skellent/GreenHouse/prompts/unpacked_original/word/media/image8.jpg

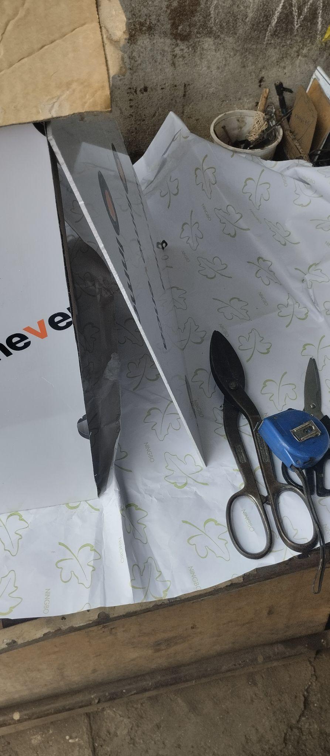
prompts/unpacked_original/word/media/image8.jpg
