skellent/GreenHouse/prompts/unpacked_original/word/media/image4.jpg

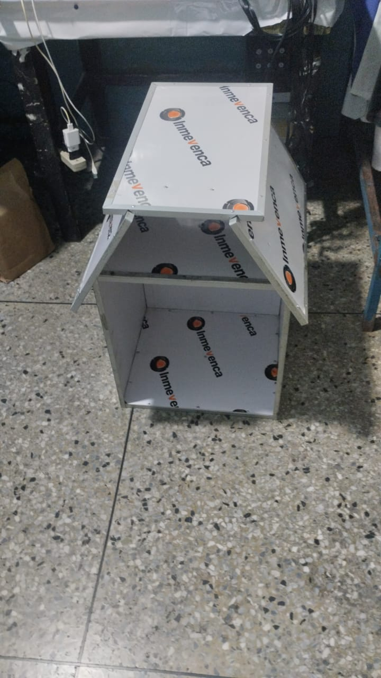
prompts/unpacked_original/word/media/image4.jpg
