skellent/GreenHouse/prompts/INFORME_ORIGINAL.docx

Olimpiadas de Robótica Creativa (ORC)

COMPETENCIA INGENIO CREATIVO

INFORME TÉCNICO

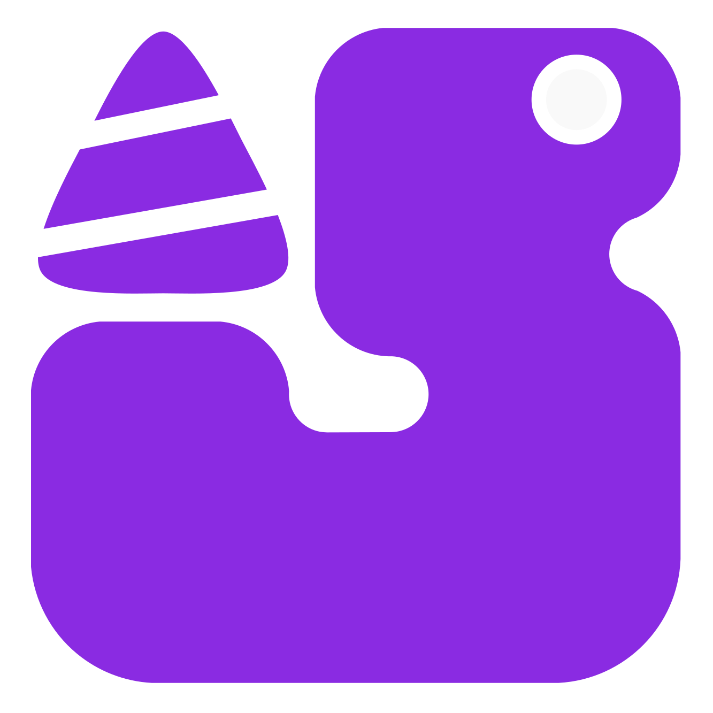
[picture p3: figure]

Skellent

Skell’s GreenHouse

Integrantes:------------------------------------------------

- Robert Rodríguez, V-32.942.787, 17 Años.----
- Christopher Ramírez, V-33.499.939, 16 Años.
- Fabiana Hernández, V-34.648.529, 14 Años.-

Tutor: Jesús Pérez, V-30.759.313

Barquisimeto, Mayo 2026

ÍNDICE

RESÚMEN DE LA IDEA DE PROYECTO 2

INTEGRANTES DEL EQUIPO DE PROYECTO 2

IMPLEMENTACIÓN DEL PROYECTO 3

INICIO 3

DESARROLLO 4

PRINCIPALES DIFICULTADES Y SOLUCIONES 4

MATERIALES DEFINITIVOS 4

PROGRAMACIÓN 5

ASPECTOS MECÁNICOS Y FUNCIONAMIENTO 5

ALGORITMO DE CONTROL 5

ESTRUCTURA DEL CÓDIGO 6

EJECUCIÓN 6

EVALUACIÓN DEL DESEMPEÑO 6

FORTALEZAS DEL SISTEMA 7

OPORTUNIDADES DE MEJORA 7

EVALUACIÓN Y ANÁLISIS DEL PROYECTO 7

LOGROS OBTENIDOS 7

APRENDIZAJES 8

ESCENARIOS DE ESCALADO 8

ESQUEMA ELECTRÓNICO 8

ESQUEMA DE FLUJO ELÉCTRICO 8

REFERENCIAS BIBLIOGRÁFICAS 8

FOTOGRAFÍAS 8

# RESÚMEN DE LA IDEA DE PROYECTO

Skell’s GreenHouse es un sistema de invernadero autónomo, portátil y modular, diseñado para facilitar el cultivo de hortalizas de pequeño porte como cebollín y zanahoria o plantas que requieran de un cuidado preciso, como flores. Su propósito es resolver la dificultad que enfrentan muchas personas al intentar mantener plantas durante su germinación y crecimiento, especialmente en espacios domésticos y educativos.

El prototipo integra un microcontrolador ESP32, sensores de humedad de tierra, temperatura ambiente, nivel de agua, y una bomba de riego, contando también con un servomotor para el posicionamiento adecuado del sensor de humedad de tierra. Además, cuenta con luces UV para suplementar la fotosíntesis y una aplicación que muestra en tiempo real las condiciones del cultivo. Una de sus características innovadoras es la integración de una IA en la ESP32, entrenada para identificar del tipo de cultivo así como el cuidado y mantenimiento del mismo, permitiendo el monitoreo remoto desde cualquier dispositivo conectado a la misma red. (Una de las actualizaciones realizadas al prototipo para la Fase Regional, fue la eliminación de la Pantalla TFT 2´8, el reemplazo de la página web por la aplicación móvil y la integración de la IA)

El proyecto se enmarca en el Motor Agroalimentario del estado Lara, contribuyendo a la producción de alimentos a pequeña escala y fomentando la educación agrícola en escuelas y hogares. Su diseño modular permite intercambiar macetas fácilmente, adaptándose a distintas especies.

Las pruebas realizadas en el hogar de uno los integrantes demostraron un crecimiento saludable y continuo del cebollín, con un sistema de riego preciso y notificaciones claras en la aplicación. De esta forma, Skell’s GreenHouse no solo automatiza el cuidado de las plantas, sino que también democratiza el acceso a la tecnología agrícola, promoviendo la soberanía alimentaria desde el ámbito local.

# INTEGRANTES DEL EQUIPO DE PROYECTO

El equipo Skellent se formó a partir de la amistad y el interés compartido por la robótica y la electrónica. Los integrantes Robert y Christopher se conocían por proyectos previos elaborados en conjunto, y al momento de considerar elaborar el proyecto, decidieron incorporar a Fabiana; Robert y Fabiana se conocen por estudiar en el mismo colegio, mientras que Christopher estudia en otro, pero eso no fue una limitante y en conjunto decidimos unir nuestras habilidades para abordar un problema real observado en sus hogares: el olvido del riego y la falta de control ambiental para plantas pequeñas. Cada miembro asumió roles específicos basados en sus fortalezas:

- Robert Rodríguez (17 años): Responsable de la programación del ESP32, creación de la aplicación y entrenamiento de la IA
- Christopher Ramírez (16 años): Diseño mecánico, electrónico y estructural. Encargado del diseño de la carcasa, el sistema modular de macetas y la impresión 3D de los componentes.
- Fabiana Hernández (14 años): Electrónica y documentación. Supervisó el conexionado de sensores, actuadores y la fuente de alimentación, además de gestionar las pruebas y el registro fotográfico.

# IMPLEMENTACIÓN DEL PROYECTO

## INICIO

La idea de Skell’s GreenHouse nació de experiencias previas con un proyecto anterior a menor escala: un medidor de datos de una maceta. Al observar que muchas plantas en sus hogares morían por falta de atención durante viajes o por condiciones ambientales desfavorables, los integrantes decidieron ampliar el concepto para crear un sistema autónomo que no solo monitoreara, sino que también actuara para mantener las plantas saludables.

Antes de iniciar, investigaron productos comerciales como sistemas de riego automático e invernaderos domésticos. Encontraron que la mayoría eran costosos, no permitían la portabilidad y no ofrecían opciones de monitoreo remoto. También revisaron trabajos académicos sobre agricultura de precisión a pequeña escala, que inspiraban el uso de sensores asequibles y microcontroladores como el ESP32.

Al inicio del proyecto, los materiales disponibles eran limitados: una placa ESP32, algunos sensores, una bomba de agua y cartón para estructurar el primer boceto.

## DESARROLLO

El desarrollo se organizó en fases:

1. Definición de requerimientos.
2. Diseño conceptual.
3. Prototipado electrónico.
4. Construcción mecánica.
5. Programación y pruebas.
6. Iteración final.
7. Mejoras

Aunque es el primer prototipo funcional, se realizaron dos iteraciones internas: una versión con estructura de cartón para validar la estructura y sus medidas, y la versión final con PVC expandido y marcos de aluminio.

### PRINCIPALES DIFICULTADES Y SOLUCIONES

- Configuración de la IA: Se utilizo la librería del Tensor Flow Lite ESP32 para la creación de la IA , para lo cual fue necesario realizar múltiples pruebas para se logró estabilización y correcta interacción.
- Suministro de Agua: Inicialmente la bomba no alcanzaba a succionar el agua desde el tanque. Se aumentó la altura de la manguera y se colocó la bomba en la parte baja del tanque.
- Modularidad: Cada pieza del invernadero (tanto estructurales como electrónicas) están hechas para ser de fácil acceso y fácil recambio en caso de ser necesario. Así como con la ayuda de un motor paso a paso se realiza la inserción del sensor de humedad de tierra, permitiendo un fácil intercambio de macetas

### MATERIALES DEFINITIVOS

- Estructura: láminas de PVC expandido, marcos de aluminio, piezas impresas en 3D (PLA-PETG).
- Electrónica: ESP32, sensor de humedad de suelo (Fc-28), sensor de temperatura y humedad DHT22, sensor de nivel de agua (genérico), bomba de agua DC 5V, motor paso a paso 28byj-48, sensores de temperatura DS18B20, fuente conmutada 5V 5A, resistencias, transistores, luces UV, Botón, Baquelita, modulo reductor de voltaje step down LM2596 y fotoresistencia (Para esta fase fue añadida la fotoresistencia , las luces Led, Sensores de temperatura DS18B20)
- Conexiones: cables DuPont, conectores terminales para partes de alto consumo.

### PROGRAMACIÓN

Se utilizó Arduino C++ en el Arduino IDE debido a la gran cantidad de librerías disponibles (WiFi, Tensor Flow Lite ESP32, DHT, etc.) que aceleraron el desarrollo.

Para desarrollar la aplicación de monitoreo se utilizó el lenguaje Java Script ya que permite una amplia optimización y mejor estética.

(La aplicación se agrego para la Fase Regional)

### ASPECTOS MECÁNICOS Y FUNCIONAMIENTO

El sistema se divide electrónicamente en:

1. Placa principal: Es la que tiene el esp32 y se encarga del manejo de sensores y actuadores
2. Placas Secundarias: módulos como el Fc-28, las luces UV, etc requieren de placas adicionales para su correcto funcionamiento, las cuales están conectadas a la principal de tal manera que permitan una fácil manipulación y reemplazo en caso de ser necesario.

Mecánica-estructuralmente se divide en:

3. Marco de aluminio: Es la estructura base que le da fuerza y estabilidad
4. Placas de PVC expandido: Estas aíslan a los componentes y la planta del exterior, protegiéndolos del agua, luz, calor, etc.
5. Puerta para la observación de la planta, con sistema de imanes

## ALGORITMO DE CONTROL

1. El ESP32 ejecuta un bucle principal (Core 1) que:
  - Se encarga de la gestión de la inteligencia artificial y el flujo lógico de los actuadores.
  - Coordina la lectura de periféricos y el formateo de datos para la red neuronal.
  - Proporciona retroalimentación visual del estado del sistema mediante un LED Neopixel (Blanco: Inicio, Verde: Éxito IA, Rojo: Error IA).
2. Se ejecuta el proceso de actualización de sensores:
  - Se leen los datos físicos (DHT, Ultrasonido, Humedad de suelo, Nivel de agua, Fotoresistencia).
  - Se actualizan las variables globales con los valores del entorno en tiempo real.
3. La Red Neuronal (IA) procesa los datos:
  - Formateo: Los datos crudos se normalizan (escala de 0.0 a 1.0) para ser digeribles por el modelo.
  - Inferencia: El intérprete de TensorFlow Lite analiza los datos de entrada.
  - Control de Actuadores: Se actualizan las variables de salida (uv, bomba) según la decisión de la IA.
4. El Servidor Web es delegado al procesador secundario (Core 0):
  - Gestiona la conexión WiFi de forma independiente para no interrumpir el ciclo de la IA.
  - Expone una API JSON con los datos de los sensores y sirve capturas en tiempo real de la cámara OV2640.

## ESTRUCTURA DEL CÓDIGO

- Setup():
  - Inicializa la comunicación Serial y los sensores (DHT, OneWire, Ultrasonido).
  - Configura los canales PWM (LEDC) para los actuadores (Bombas y luces UV).
  - Inicia la cámara OV2640 gestionando la memoria DRAM.
  - Carga el modelo de IA en la tensor_arena y prepara los tensores de entrada/salida.
  - Crea la tarea del Servidor Web asignándola específicamente al núcleo 0 con xTaskCreatePinnedToCore.
- Loop():
  - Indica el inicio de la iteración con el Neopixel.
  - Llama a actualizarSensores() para refrescar las variables globales.
  - Ejecuta formatearSensores() para normalizar los valores.
  - Inserta los datos en el modelo de IA y ejecuta el interpreter->Invoke().
  - En base al éxito o error de la IA, actualiza el estado de los actuadores y el color del LED.
  - Genera un reporte de monitoreo mediante la función log().
- Funciones Secundarias:
  - actualizarSensores(): Lee pines analógicos y digitales, aplicando map y constrain para calibrar niveles de agua y tierra.
  - formatearSensores(): Realiza las operaciones matemáticas para convertir los rangos de sensores a valores flotantes compatibles con la red neuronal.
  - ServidorWeb(): Bucle infinito en el núcleo 0 que maneja peticiones HTTP, genera el JSON de estado y sirve el buffer de imagen de la cámara.
- Variables Globales:
  - Sensores: sen_humedadAire, sen_humedadTierra, sen_litrosAgua, sen_alturaPlanta, sen_temperatura, sen_luz.
  - IA (Raw): raw_temperatura, raw_humedadAire, raw_humedadTierra, raw_luz, raw_litrosAgua.
  - Actuadores: uv, bomba, camaraOk.

## EJECUCIÓN

El prototipo se sometió a prueba en la casa de uno de los integrantes (Robert). En el que se instaló la maceta con un cebollín en crecimiento para ver cómo se desarrollaba dentro del prototipo, mostrando buenos resultados.

### EVALUACIÓN DEL DESEMPEÑO

El sistema se consideró óptimo cuando se cumplieron tres criterios:

1. Crecimiento Continuo: la planta demostró un crecimiento continuo y saludable.
2. Precisión en El Riego y Luz: Las IA demostró ser efectiva, debido a que la bomba se activó solo cuando la humedad del suelo descendió por debajo del umbral configurado, sin inundaciones ni sequías y las luces se activaron el tiempo indicado con la potencia indicada.
3. Confiabilidad de la aplicación: los datos mostrados coincidían con las mediciones manuales realizadas con instrumentos de referencia.

### FORTALEZAS DEL SISTEMA

- Autonomía Total mediante la IA: no requiere intervención humana para mantener las condiciones adecuadas (solo para el rellenado ocasional del tanque de agua, aunque se tiene pensado una solución al respecto).
- Modularidad: permite cambiar de cultivo fácilmente, y esta diseñado electrónica y estructuralmente para ser fácilmente reparable o modificable.
- Monitoreo Remoto: la aplicación facilita el monitoreo remoto de la planta desde cualquier dispositivo conectado a la misma red.
- Portabilidad: su tamaño y peso permiten trasladarlo sin dificultad (a comparación de otros invernaderos).

### OPORTUNIDADES DE MEJORA

- Incorporar sensores de pH y nutrientes para la app.
- Optimizar el consumo energético mediante modos de suspensión.
- Desarrollar una base de datos de plantas con parámetros predefinidos para facilitar la configuración.
- Añadir un sistema de recolección de agua mediante placas peltier

# EVALUACIÓN Y ANÁLISIS DEL PROYECTO

Skell’s GreenHouse responde a la problemática de la seguridad alimentaria desde el nivel doméstico y educativo, en línea con el Motor Agroalimentario del estado Lara. Al automatizar el cuidado de hortalizas pequeñas y plantas delicadas o de difícil cuidado, reduce la dependencia de la atención humana constante y permite a familias y escuelas producir sus propios alimentos o cuidar plantas exóticas de manera sencilla y controlada. Además, fomenta el interés por la agricultura y la tecnología, especialmente en jóvenes, al ofrecer una plataforma didáctica.

## LOGROS OBTENIDOS

- Se consolidó un equipo interdisciplinario con roles claros y comunicación efectiva.
- Se logró un prototipo completamente funcional y autónomo.
- Se documentó el proceso completo, dejando evidencia del trabajo original y las soluciones implementadas.

## APRENDIZAJES

- La importancia de la modularidad para facilitar pruebas y mantenimiento.
- El manejo avanzado de librerías para la implementación de IA y servidores web en ESP32.
- La necesidad de considerar el entorno físico (humedad, temperatura) en el diseño mecánico para evitar daños a la electrónica.

## ESCENARIOS DE ESCALADO

- Escala educativa: Versión en kit de componentes para escuelas, con manuales didácticos.
- Escala comunal: Adaptación a un módulo más grande que permita el cultivo de múltiples macetas en espacios comunitarios.
- Escala comercial: Reducción de costos mediante diseño optimizado para producción en serie, manteniendo la modularidad.

# ESQUEMA ELECTRÓNICO

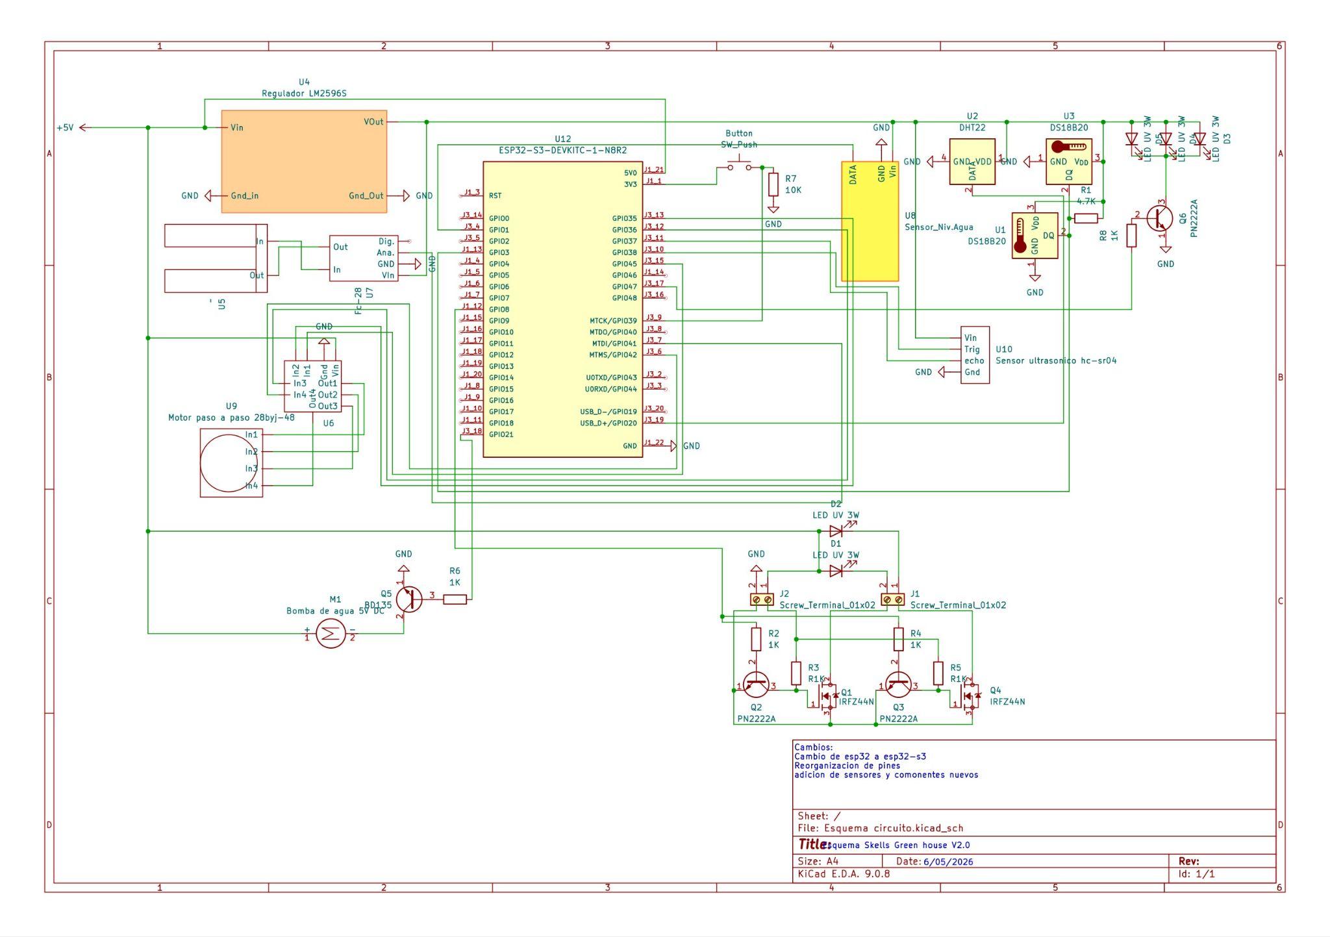
[picture p4: figure]

# ESQUEMA DE FLUJO ELÉCTRICO

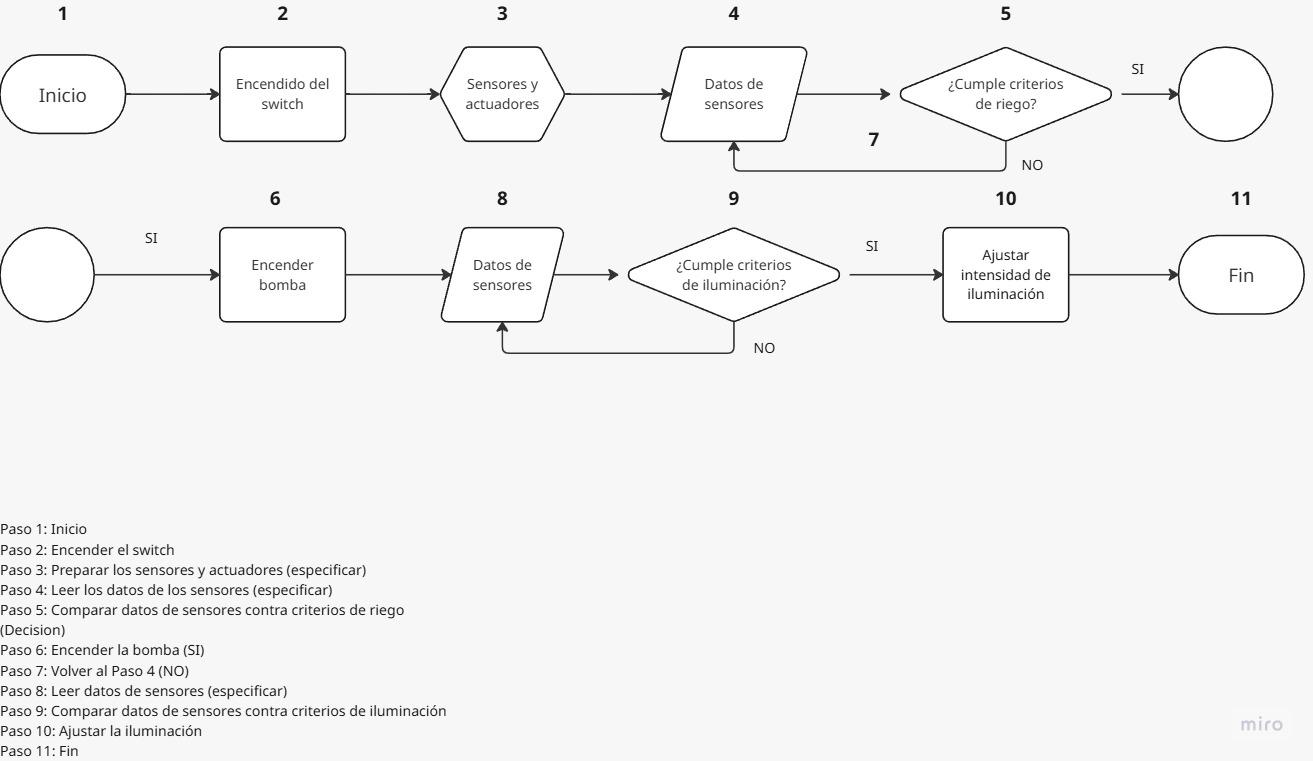
[picture p5: figure]

# FOTOGRAFÍAS

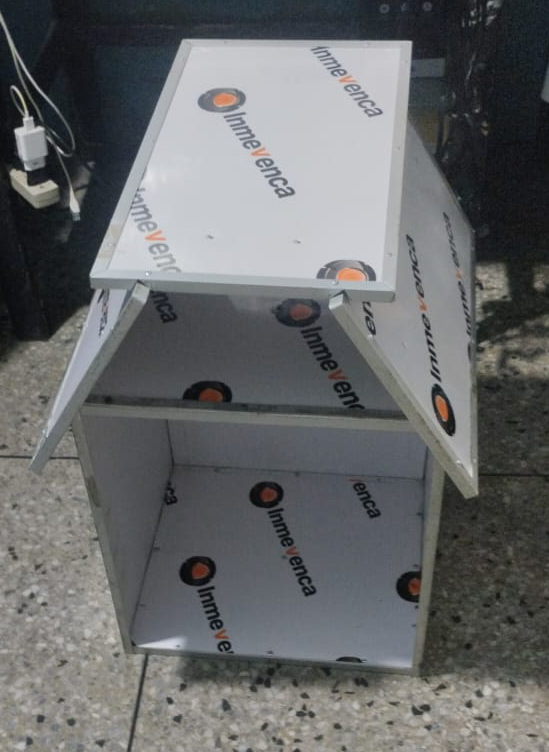
[picture p6: figure]
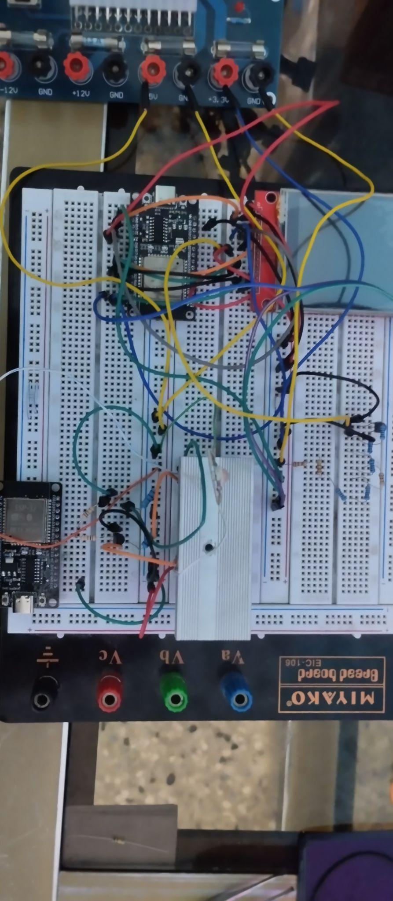
[picture p7: figure]
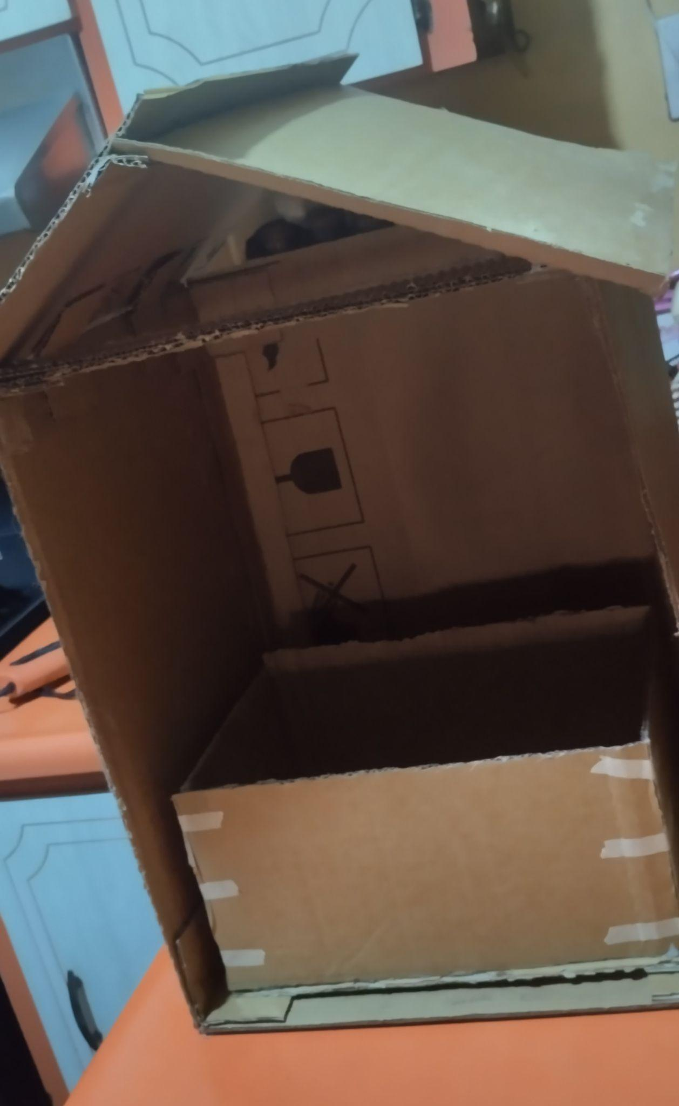
[picture p8: figure]
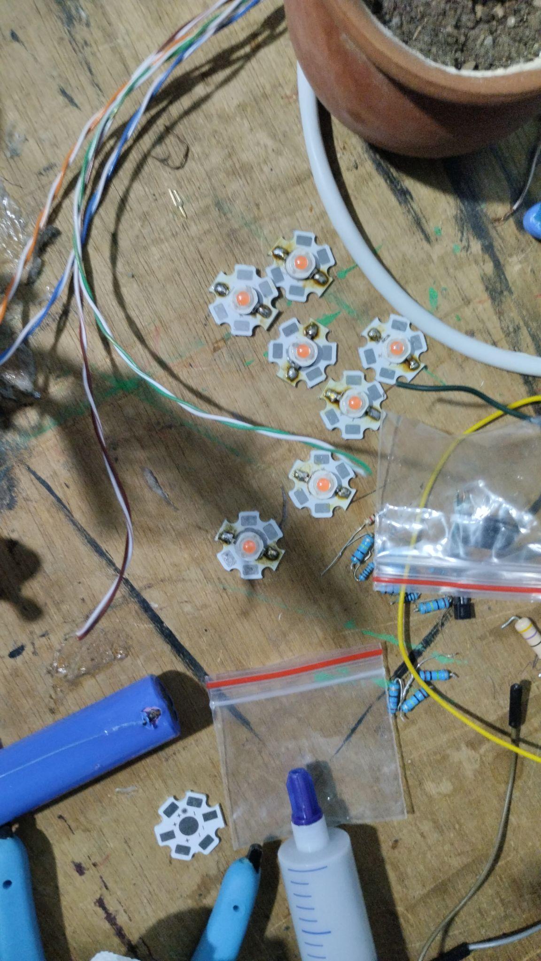
[picture p9: figure]
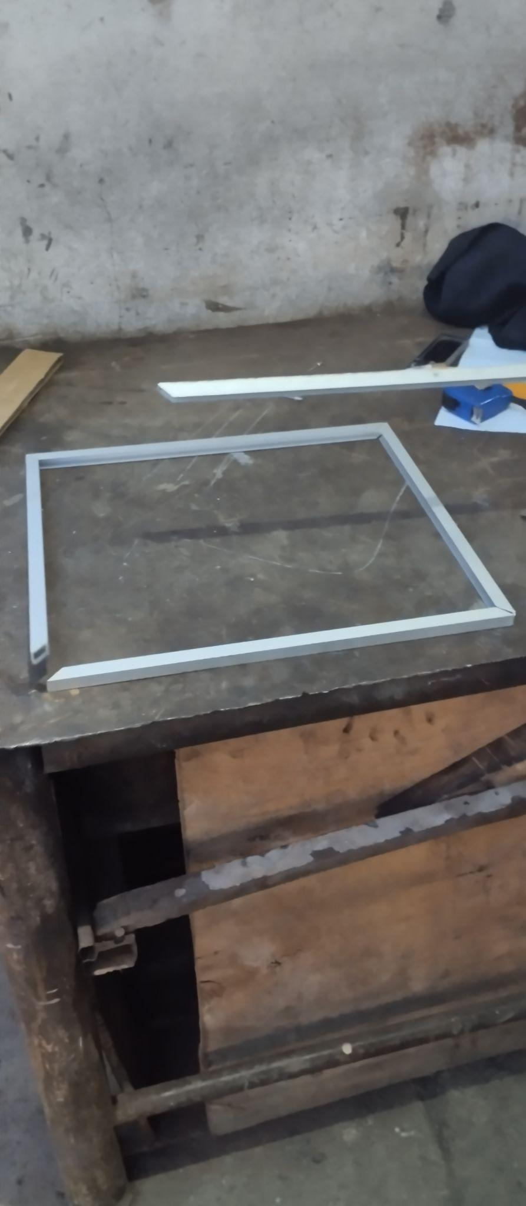
[picture p10: figure]
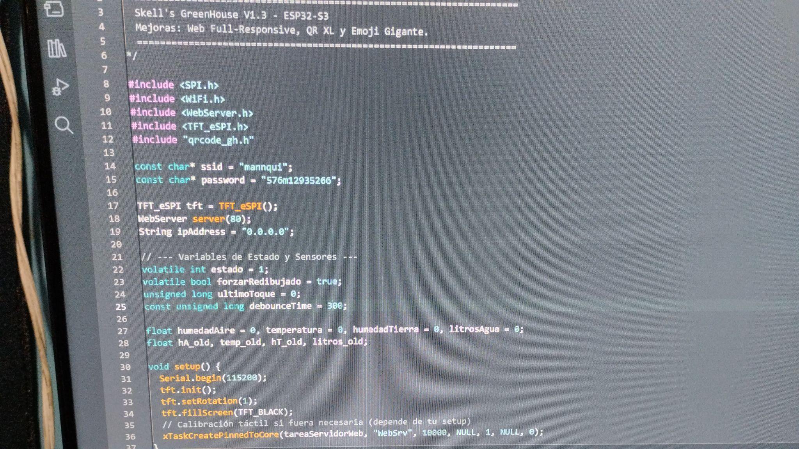
[picture p11: figure]
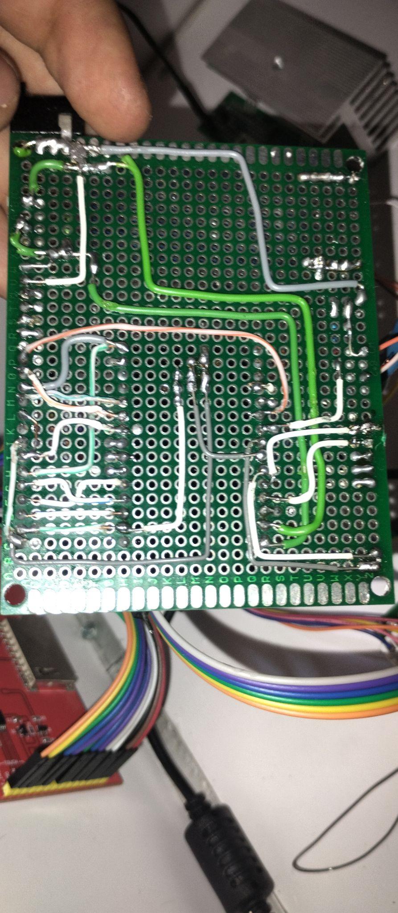
[picture p12: figure]

# REFERENCIAS BIBLIOGRÁFICAS

#### 1. Fundamentos de Invernaderos Inteligentes y Agricultura de Precisión

Heuvelink, E., Hemming, S., & Marcelis, L. F. M. (2025). Some recent developments in controlled-environment agriculture: on plant physiology, sustainability, and autonomous control. The Journal of Horticultural Science and Biotechnology, *100*(5), 604–614. https://doi.org/10.1080/14620316.2024.2440592

Kim, J., Lee, H., & Park, S. (2025). Multi-Sensor Monitoring, Intelligent Control, and Data Processing for Smart Greenhouse Environment Management. Sensors, *25*(19), 6134. https://doi.org/10.3390/s25196134

#### 2. Tecnologías de Sensores y Control

Heuvelink, E., Hemming, S., & Marcelis, L. F. M. (2025). Some recent developments in controlled-environment agriculture: on plant physiology, sustainability, and autonomous control. The Journal of Horticultural Science and Biotechnology, 100(5), 604–614. https://doi.org/10.1080/14620316.2024.2440592 (Sección sobre uso de espectro de luz LED y fisiología vegetal.)

Kim, J., Lee, H., & Park, S. (2025). Multi-Sensor Monitoring, Intelligent Control, and Data Processing for Smart Greenhouse Environment Management. Sensors, 25(19), 6134. https://doi.org/10.3390/s25196134 (Análisis detallado de redes de sensores, técnicas de filtrado de datos y estrategias de control.)

#### 3. Internet de las Cosas (IoT) y Monitoreo Remoto

Kim, J., Lee, H., & Park, S. (2025). Multi-Sensor Monitoring, Intelligent Control, and Data Processing for Smart Greenhouse Environment Management. Sensors, 25(19), 6134. https://doi.org/10.3390/s25196134 (Discute el uso de plataformas IoT y protocolos de comunicación como Wi-Fi para la automatización.)
