skellent/GreenHouse/Chris/Proyecto.docx

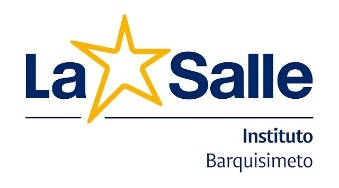
[picture p13: figure]
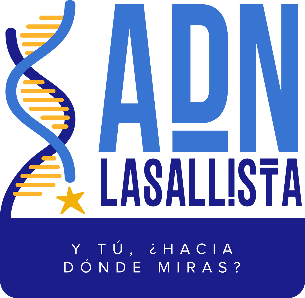
[picture p14: figure]

Republica bolivariana de Venezuela

Ministerio del Poder popular para la Educacion

Unidad Educativa Instituto LaSalle

Desarrollo de un Prototipo y Aplicación Inteligente Para el Cuidado Autónomo de las Plantas

Tutor:

Prof.Maria Josefina Guzmán

Integrantes:

José González

Christopher Ramirez

Cristina dueñas

Camila Carrillo

Planteamiento del problema

En la actualidad se puede observar un mal cuidado de plantas en el mundo, con algunos factores a destacar; como la deforestación de áreas verdes para la urbanizacion, aumentando el calentamiento global principalmente en zonas urbanas. Esto es nocivo para el mundo, aunque países como Brazil, Colombia y Venezuela le an restado importancia a lo largo de los años, cobrando en sí la Biodiversidad de las Plantas.

Existe una contradicción evidente entre la necesidad urgente de incorporar más vegetación en los entornos urbanos para mitigar la contaminación y la pérdida de espacios verdes, y la dificultad práctica de los habitantes de la ciudad para mantenerlas vivas debido a la gestión ineficiente del riego. Los métodos tradicionales de riego dependen de la memoria y la presencia constante de las personas, lo cual es incompatible con la dinámica urbana.

En este escenario, la introducción de vegetación en interiores y espacios urbanos se presenta como una solución paliativa crucial. Las plantas mejoran la calidad del aire interior, absorben CO2 liberan oxígeno, reducen el estrés y aumentan el bienestar psicológico. Sin embargo, el estilo de vida urbano, marcado por la falta de tiempo y las frecuentes ausencias del hogar, la necesidad de continuar con la urbanizacion y lo costoso que puede resultar para el estado plantar y cuidar plantas, convierte el tener espacios verdes o algunas plantas en un obstáculo significativo. Esto resulta en una alta tasa de mortalidad de las plantas, lo que, irónicamente, desincentiva a las personas a intentar integrar la naturaleza en sus espacios, perpetuando el ciclo de déficit de verdor.

En Venezuela no se es tan evidente esta falta de espacios verdes ya que el pais tiene gandes selvas y zonas tropicales, en zonas las zonas pobladas de los estados como Caracas, Lara, Zulia,etc. Se puede evidenciar una alta cantidad de contaminacion proviniente de autos, negocios y personas y la falta de plantas o espacios verdes agrava mas esta situacion. Toda esta contaminacion aparte de suponer un gran problema para el ambiente tambien puede llegar a ser muy perjudicial para las personas sobretodo para aquellas que transitan seguido estas areas.

A nivel regional en el estado lara se puede apreciar lo anteriormente mencionado, siendo el centro de la ciudad un claro ejemplo: Ya que esta zona es un espacio casi en su totalidad cubierto con cemento y con muy pocos arboles, todo esto junto con que es altamente transitada hace que se acumule la contaminacion. Y dentro de los edificios o casas no cambia mucho pues aunque es comun encontrar plantas dentro de los hogares poco a poco se a visto una reduccion en su cantidad mientras que en los edificios ya casi no se pueden observar ninguna afectando a las personas no solo fisica si no tambien psicologicamente, como se menciono anteriormente, pues la falta de plantas o espacios verdes puede hacer decaer el estado de animo de las personas
