skellent/GreenHouse/alicia/entrenamiento.png

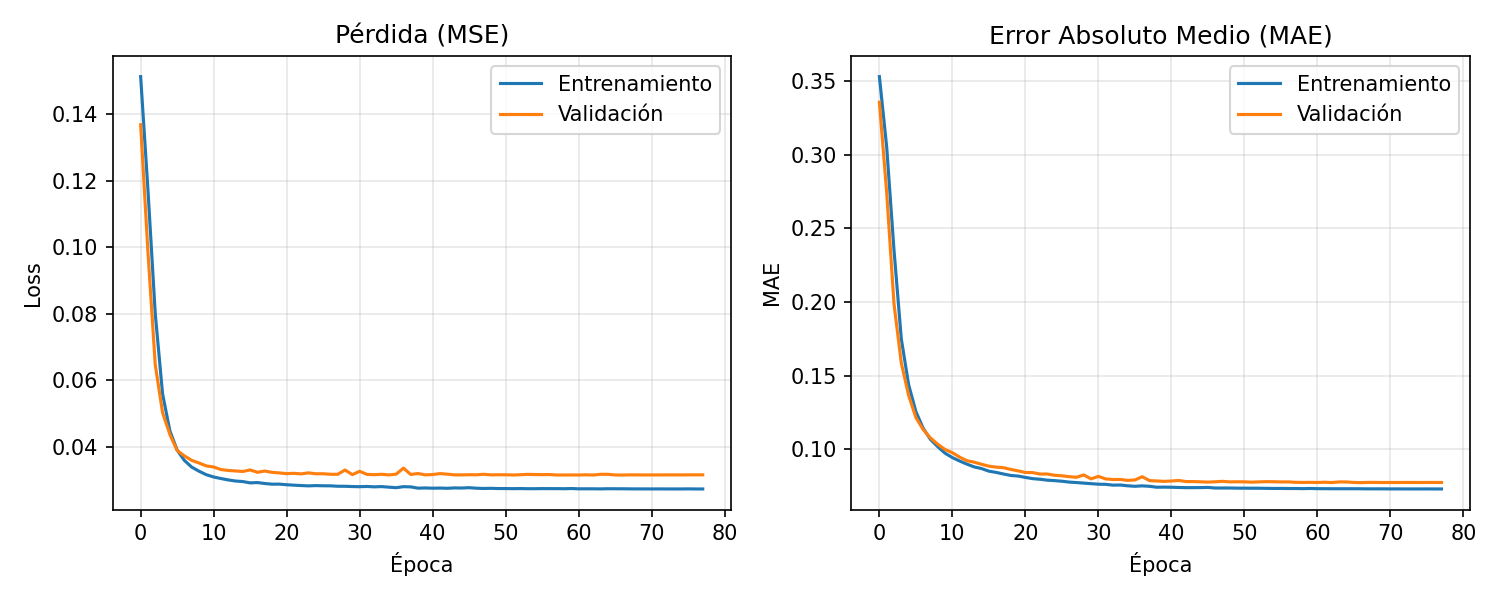
alicia/entrenamiento.png
