skellent/GreenHouse/prompts/anexo1.jpeg

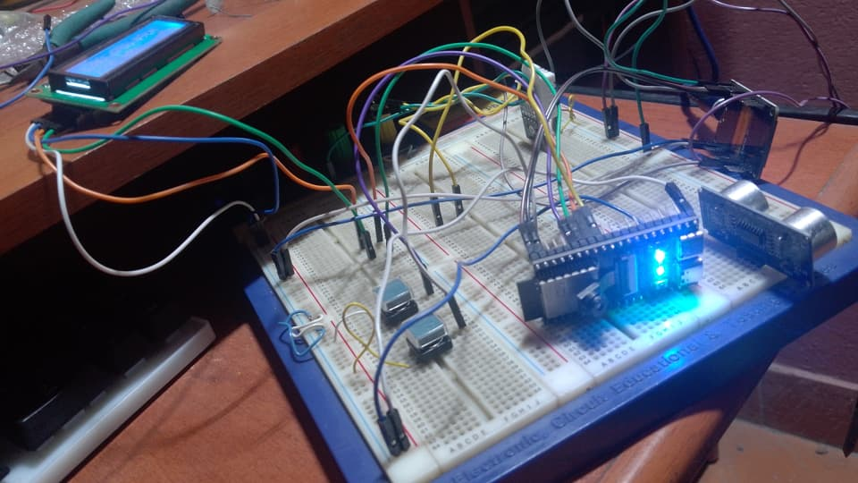
prompts/anexo1.jpeg
