skellent/GreenHouse/prompts/anexo2.jpeg

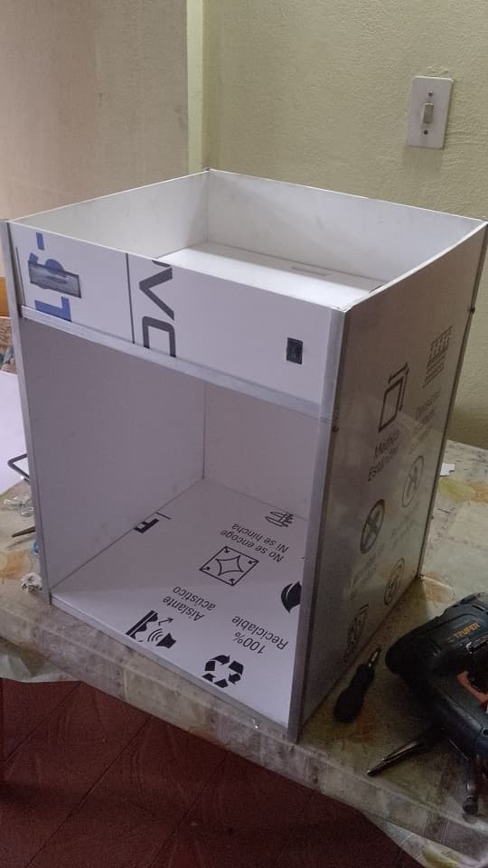
prompts/anexo2.jpeg
