skellent/GreenHouse/prompts/anexo3.jpeg

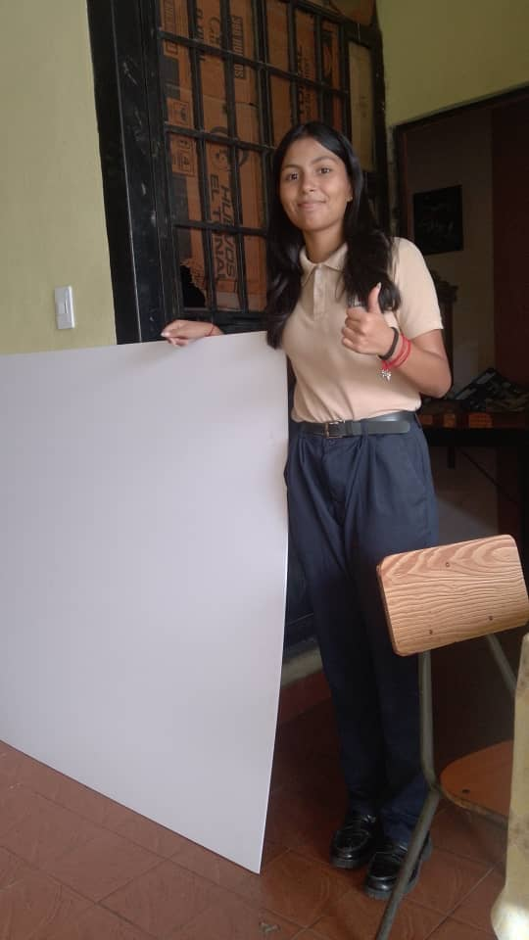
prompts/anexo3.jpeg
