skellent/GreenHouse/prompts/anexo4.jpeg

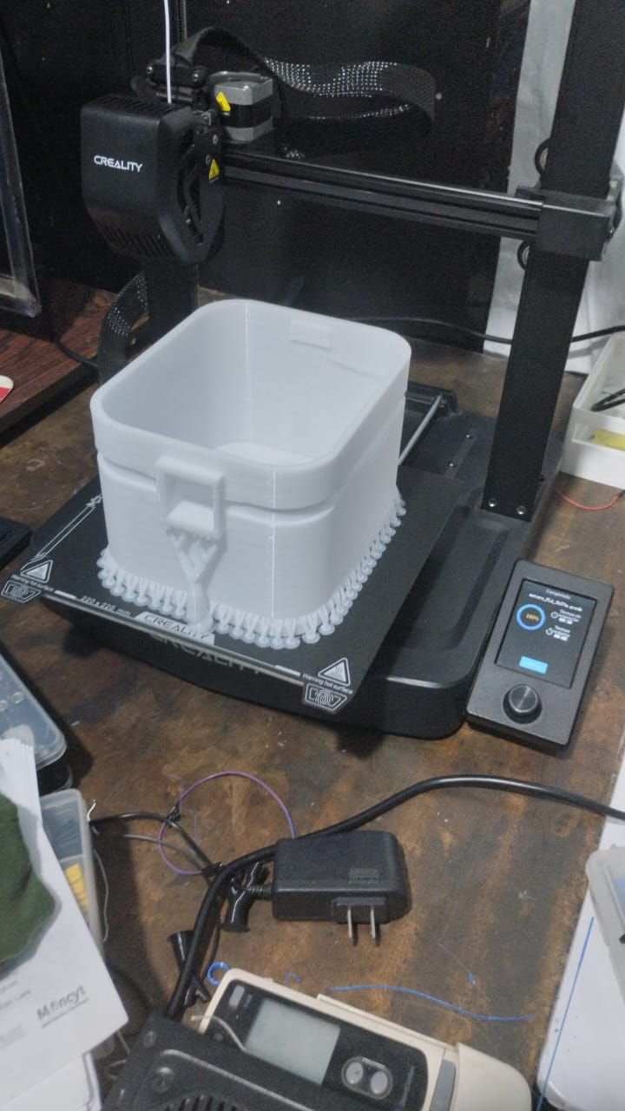
prompts/anexo4.jpeg
