skellent/GreenHouse/prompts/anexo5.jpeg

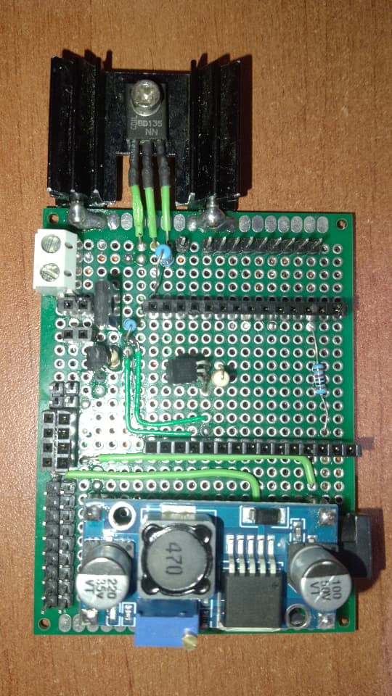
prompts/anexo5.jpeg
