skellent/GreenHouse/prompts/unpacked_destino/word/media/image1.png

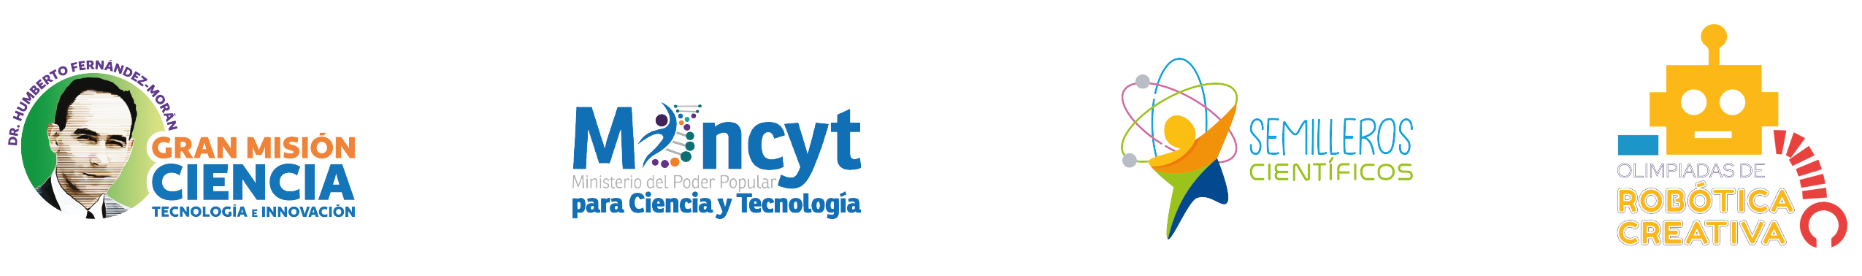
prompts/unpacked_destino/word/media/image1.png
