skellent/GreenHouse/models/LOGO.stl

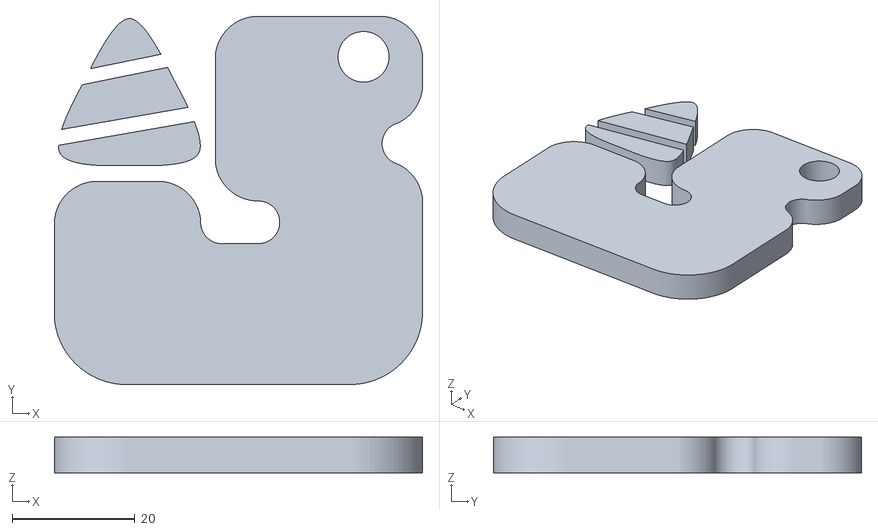
[picture p22: CAD file, 2026-05-27]
models/LOGO.stl
60.0 x 60.0 x 5.80
