skellent/GreenHouse/Chris/Esquema circuito/Esquema circuito.kicad_sch

## KiCad design Chris/Esquema circuito/Esquema circuito.kicad_sch (2026-05-16, an earlier design)

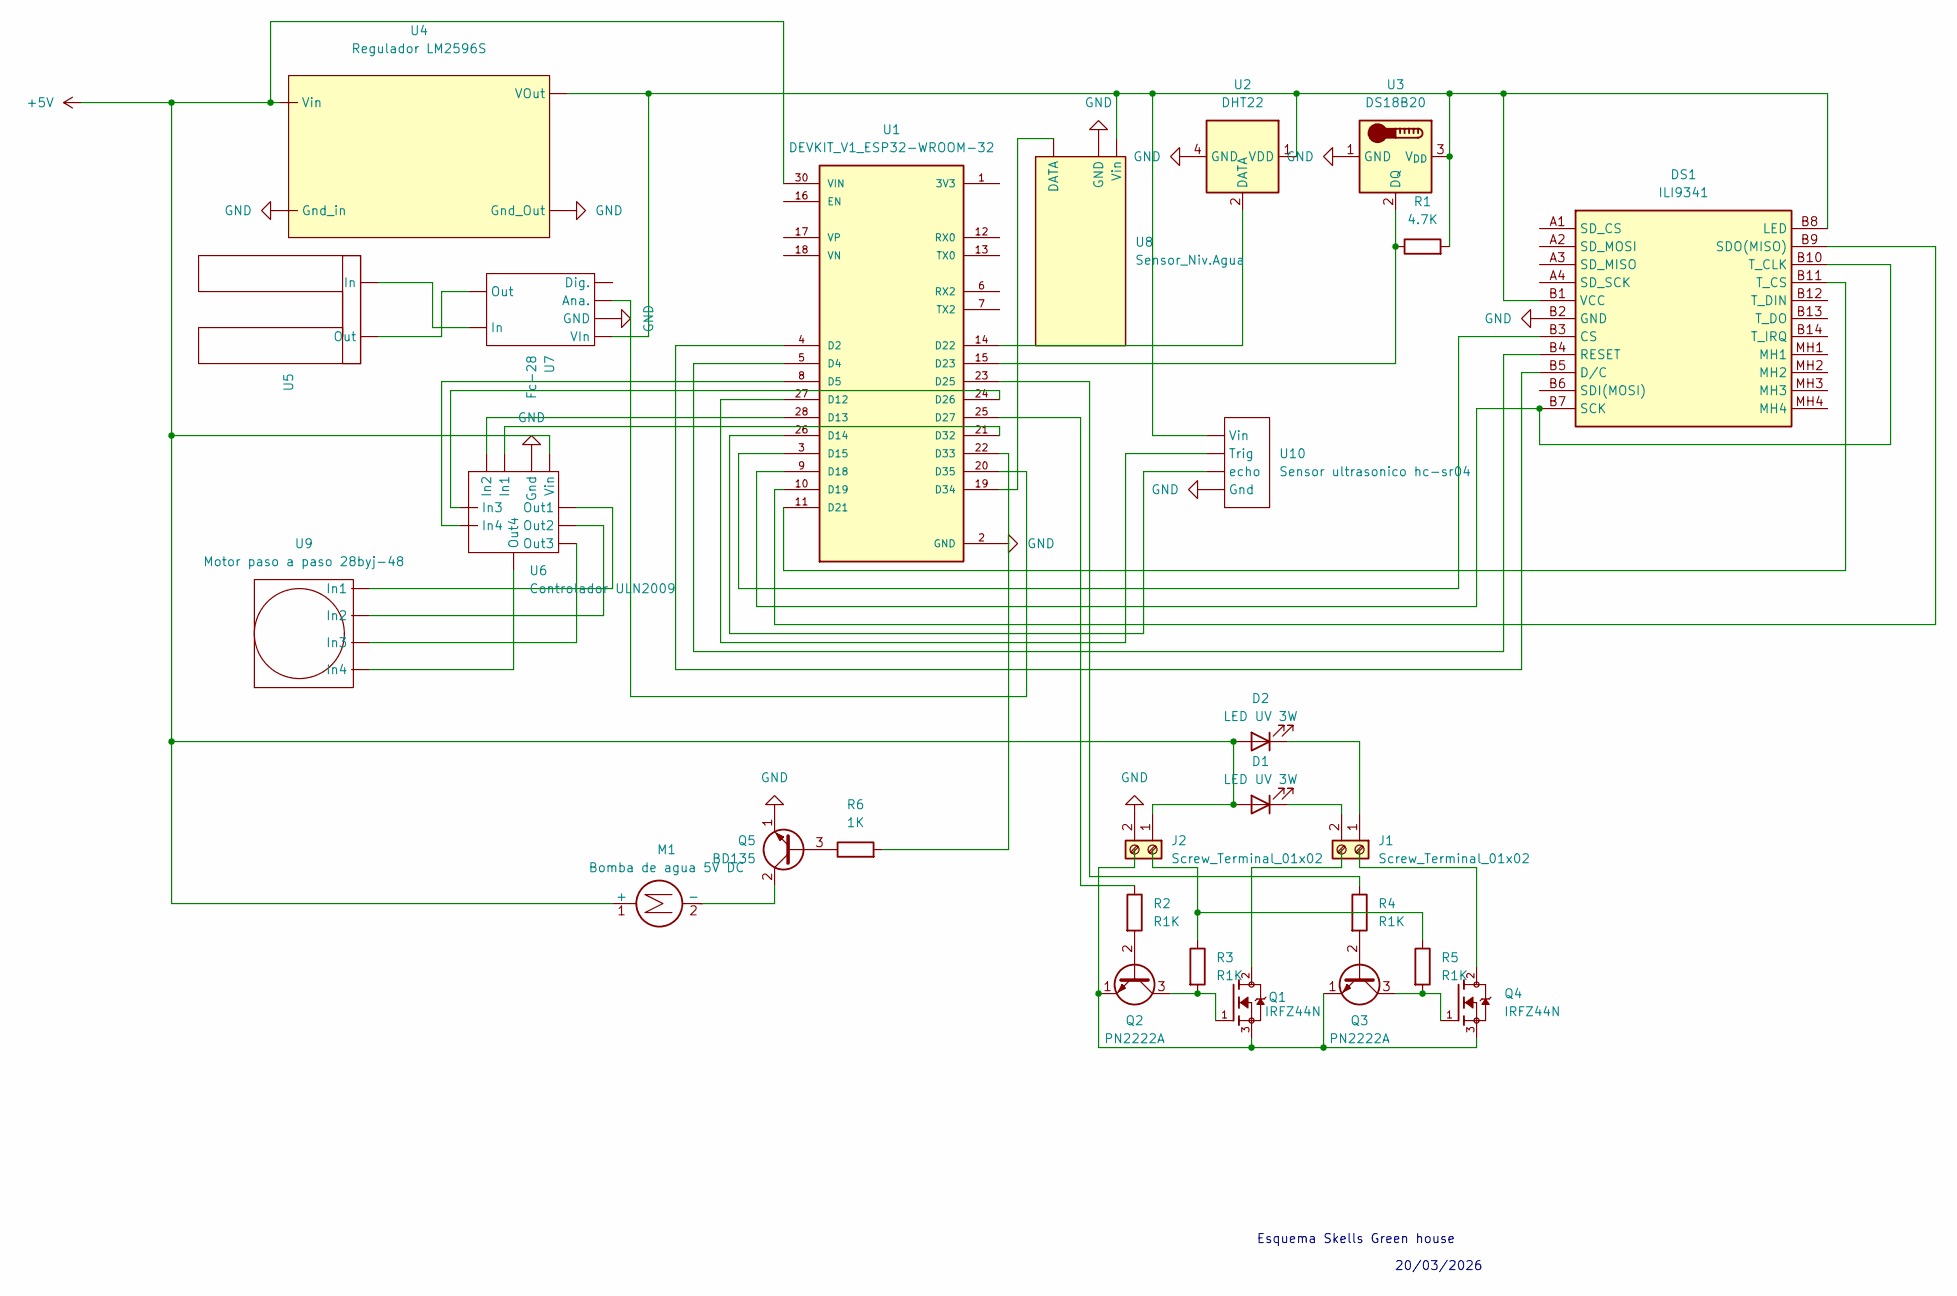
[picture p23: schematic Esquema circuito.kicad_sch]

Parts:
D1, D2: LED UV 3W
DS1: ILI9341; Manufacturer_Part_Number ILI9341
J1, J2: Screw_Terminal_01x02
M1: Bomba de agua 5V DC
Q1, Q4: IRFZ44N; TO254P1016X419X2286-3; PARTREV 09/21/10
Q2, Q3: PN2222A; TO-92_Inline
Q5: BD135; TO-126-3_Vertical
R1: 4.7K
R2, R3, R4, R5: R1K
R6: 1K
U1: DEVKIT_V1_ESP32-WROOM-32; MODULE_DEVKIT_V1_ESP32-WROOM-32
U2: DHT22; Aosong_DHT11_5.5x12.0_P2.54mm
U3: DS18B20; TO-92_Inline
U4: Regulador LM2596S
U5: (no value)
U6: Controlador ULN2009
U7: Fc-28
U8: Sensor_Niv.Agua
U9: Motor paso a paso 28byj-48
U10: Sensor ultrasonico hc-sr04

Connections:
+5V: D1.2 (A), D2.2 (A), J2.1, M1.1 (+), U1.30 (VIN), U4., U6.
GND: DS1.B2 (GND), J2.2, Q5.1 (E), U1.2 (GND), U1.29 (GND), U2.4 (GND), U3.1 (GND), U4., U6., U7., U8., U10.
unnamed: D1.1 (K), J1.2
unnamed: D2.1 (K), J1.1
unnamed: DS1.B1 (VCC), DS1.B8 (LED), R1.2, U2.1 (VDD), U3.3 (V_{DD}), U4., U7., U8., U10.
unnamed: DS1.B3 (CS), U1.3 (D15)
unnamed: DS1.B4 (RESET), U1.5 (D4)
unnamed: DS1.B5 (D/C), U1.4 (D2)
unnamed: DS1.B9 (SDO(MISO)), U1.10 (D19)
unnamed: DS1.B7 (SCK), DS1.B10 (T_CLK), U1.9 (D18)
unnamed: DS1.B11 (T_CS), U1.11 (D21)
unnamed: M1.2 (-), Q5.2 (C)
unnamed: Q1.1, Q2.3 (C), R3.2
unnamed: Q1.3, Q2.1 (E), Q3.1 (E), Q4.3
unnamed: Q2.2 (B), R2.2
unnamed: Q3.2 (B), R4.2
unnamed: Q3.3 (C), Q4.1, R5.2
unnamed: Q5.3 (B), R6.1
unnamed: R1.1, U1.15 (D23), U3.2 (DQ)
unnamed: R2.1, U1.25 (D27)
unnamed: R3.1, R5.1
unnamed: R4.1, U1.23 (D25)
unnamed: R6.2, U1.22 (D33)
unnamed: U1.8 (D5), U6.
unnamed: U1.14 (D22), U2.2 (DATA)
unnamed: U1.19 (D34), U8.
unnamed: U1.20 (D35), U7.
unnamed: U1.21 (D32), U6.
unnamed: U1.24 (D26), U6.
unnamed: U1.26 (D14), U10.
unnamed: U1.27 (D12), U10.
unnamed: U1.28 (D13), U6.
unnamed: U5., U7.
unnamed: U6., U9.

Notes on the sheet:
20/03/2026
Esquema Skells Green house
