skellent/GreenHouse/core/alicia_model.h

/*
 * alicia_model.h — PLACEHOLDER
 * ═══════════════════════════════════════════════════════════
 *
 * Este archivo es un PLACEHOLDER. Debes generarlo ejecutando
 * los scripts de Python en la carpeta alicia/:
 *
 *   1. cd alicia
 *   2. python generar_datos.py
 *   3. python entrenar_alicia.py
 *   4. python convertir_alicia.py
 *      └─ Copia alicia/alicia_model.h → core/alicia_model.h
 *
 * ═══════════════════════════════════════════════════════════
 */

#pragma once

// Detener la compilación con un mensaje claro hasta que el
// modelo real haya sido generado y copiado aquí.
#error "alicia_model.h es un placeholder. Genera el modelo ejecutando los scripts en alicia/ (ver instrucciones arriba) y luego copia alicia/alicia_model.h aqui."
