skellent/GreenHouse/core/icons.h

#include "binary.h"
#ifndef ICONS
#define ICONS
#include <Arduino.h>

byte iconoTemperatura[8] = {
  B00100, // --#--  Es un termometro
  B01010, // -#-#-
  B01110, // -###-
  B01010, // -#-#-
  B11101, // ###-#
  B10001, // #---#
  B11101, // ###-#
  B01110  // -###-
};

byte iconoHumedad[8] = {
  B00001, // ----#  Es una gota de agua
  B00011, // ---##
  B00101, // --#-#
  B01001, // -#--#
  B10001, // #---#
  B10001, // #---#
  B10010, // #--#-
  B01100  // -##--
};

byte iconoWifi[8] = {
  B00001, // ----#
  B00001, // ----#
  B00001, // ----#
  B00101, // --#-#
  B00101, // --#-#
  B10101, // #-#-#
  B10101, // #-#-#
  B10101  // #-#-#
};

byte iconoAltura[8] = {
  B01000, // -#--- Es una planta
  B10100, // #-#--
  B10110, // #-##-
  B01101, // -##-#
  B00101, // --#-#
  B00110, // --##-
  B00100, // --#--
  B00100  // --#--
};

byte iconoRed[8] = {
  B11111, // ##### Es una antena
  B10001, // #---#
  B10001, // #---#
  B11111, // #####
  B00100, // --#--
  B00100, // --#--
  B00100, // --#--
  B00100  // --#--
};

#endif
