skellent/GreenHouse/(commit log)

2026-03-08 Reestructuracion de Archivos
2026-03-09 Refactorizacion modular de Iconos hecha
2026-03-09 Refactorizacion modular de Pagina Web y Credenciales WIFI hecha
2026-03-09 Correcion de error de pagina web servida y reestructuracion para mayor legibilidad y edicion futura
2026-03-14 Correccion de errores y comentacion de codigo
2026-03-14 Archivos Iniciales de Pagina Web
2026-03-25 2:19 AM, sensores funcionales: tanqueAgua, humTierra, alturaPlanta
2026-03-29 Mejora de Pagina Web y Subida de "Suffering"
    [Esquema circuito.kicad_pcb, Esquema circuito.kicad_sch]
2026-04-13 Modificacion TOTAL del algoritmo y sistema de configuracion primario funcional
2026-04-16 Reconfigurabilidad de luces UV
2026-05-02 Red Neuronal Funcional
    [skells_greenhouse_dataset.csv]
2026-05-02 Red neuronal en ESP32 + API modificada + prototipo de App
2026-05-04 Creación de Aplicación en JS mediante Capacitor
2026-05-06 Rediseño de la App + Iconos de la misma
2026-05-06 Las Circuit
2026-05-07 Last Commit Regionales
    [Esquema circuito.kicad_sch]
2026-05-16 Inicio de Reconfiguracion
2026-05-16 Humanizacion parcial + sistema de JSONS sin probar
2026-05-22 Pantalla LCD + UART primitivo + Pre-Claude
2026-05-22 Primera Version de la App
2026-05-22 Version Definitiva de la Aplicacion
2026-05-27 Preparación para Claude
    [skells_greenhouse_dataset.csv]
2026-05-27 Creando a la IA
    [app.xml]
2026-05-27 Creación de Informe y de IA
    [datos_entrenamiento.csv]
2026-05-28 Información de Informe
2026-05-28 Temperatura Legible
